MCMElectronics/Serif-T/README.md

# Serif-TPi
T-style raspberry Pi breadboard adapter with power
