MCMElectronics/Serif-T/Serif-TPi_Images/board_outline.dxf

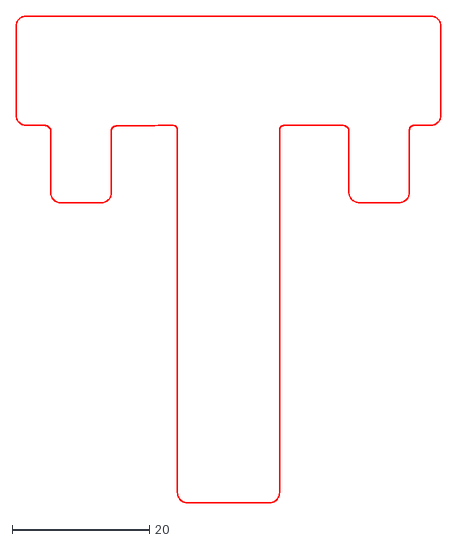
[picture p1: CAD file, 2015-08-27]
Serif-TPi_Images/board_outline.dxf
61.9 x 71.0
