MCMElectronics/Serif-T/(list of files, drawings)

Other design files:
Serif-TPi.dsn
